noah-glassford/GameHardwareBitdisk/Final Project/FinishedControllerPhotos/4.jpg

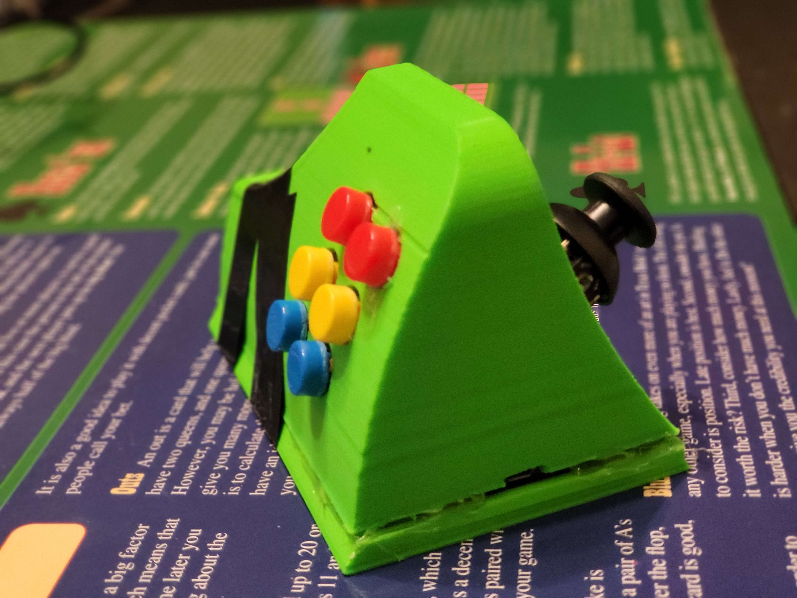
Final Project/FinishedControllerPhotos/4.jpg
