noah-glassford/GameHardwareBitdisk/Final Project/FinishedControllerPhotos/2.jpg

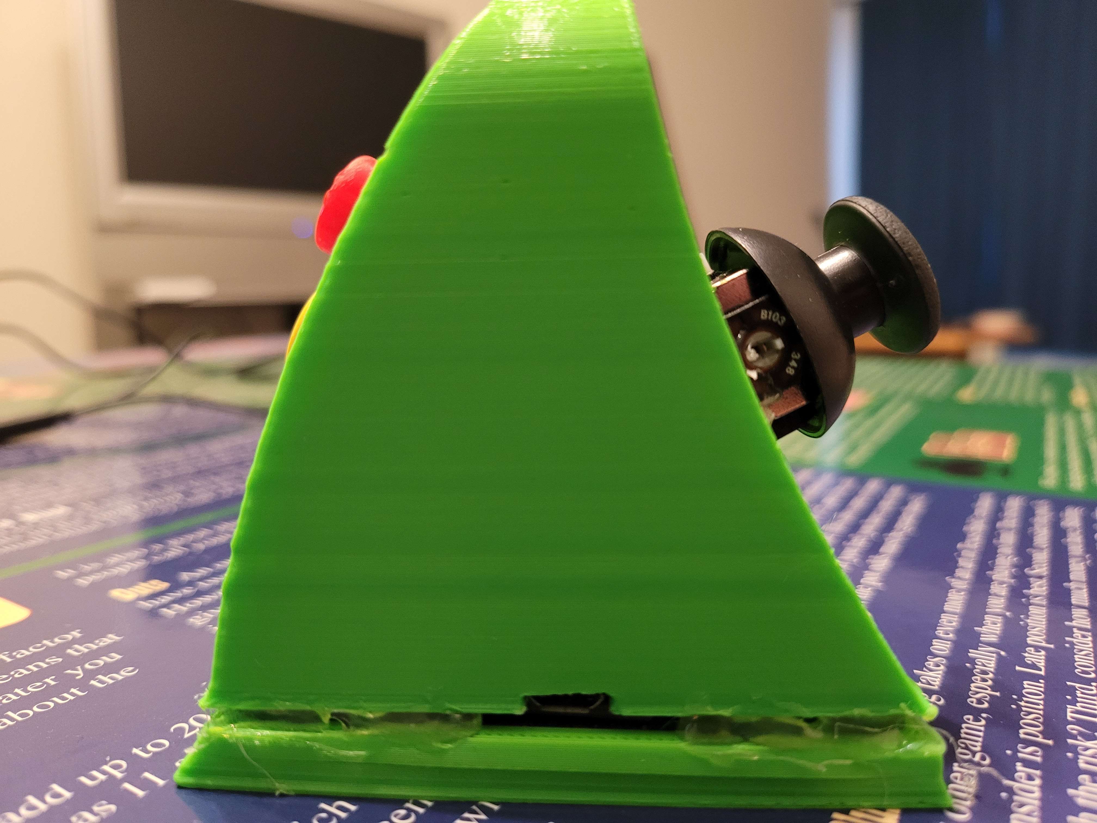
Final Project/FinishedControllerPhotos/2.jpg
