noah-glassford/GameHardwareBitdisk/Final Project/FinishedControllerPhotos/1.jpg

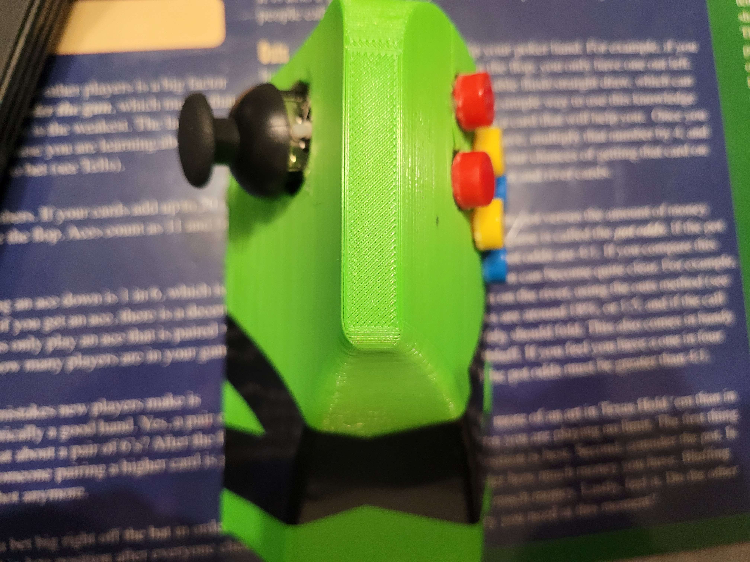
Final Project/FinishedControllerPhotos/1.jpg
