noah-glassford/GameHardwareBitdisk/Final Project/FinishedControllerPhotos/3.jpg

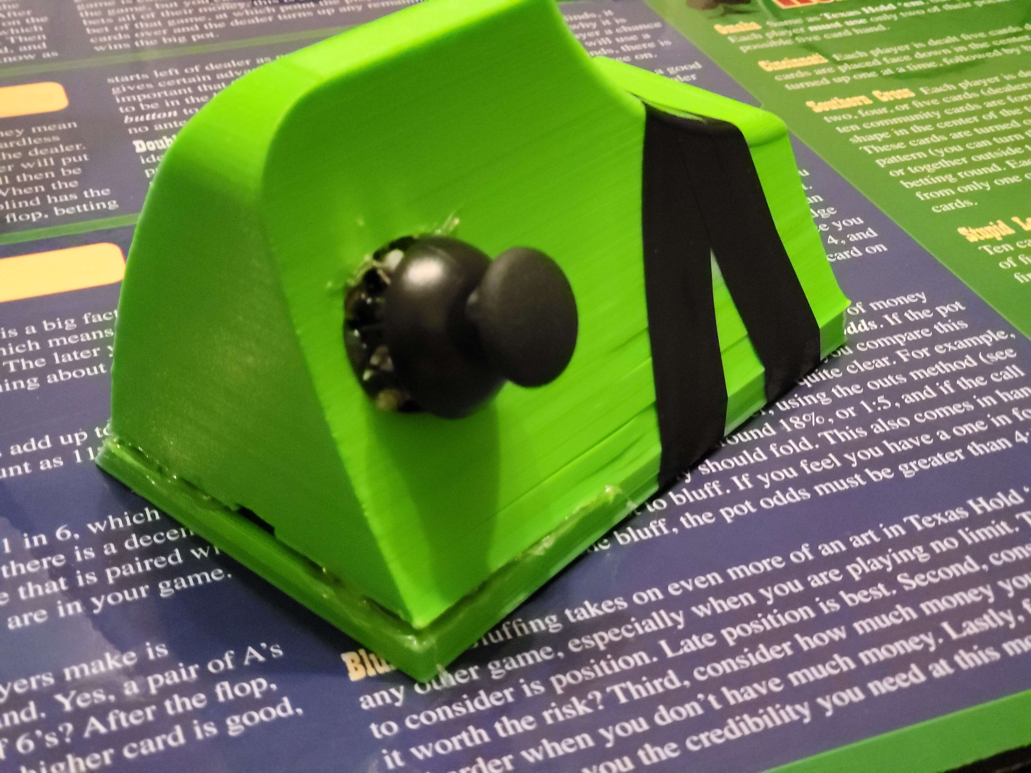
Final Project/FinishedControllerPhotos/3.jpg
