noah-glassford/GameHardwareBitdisk/Final Project/Technical Drawings/TinkercadCircuitDiagram.png

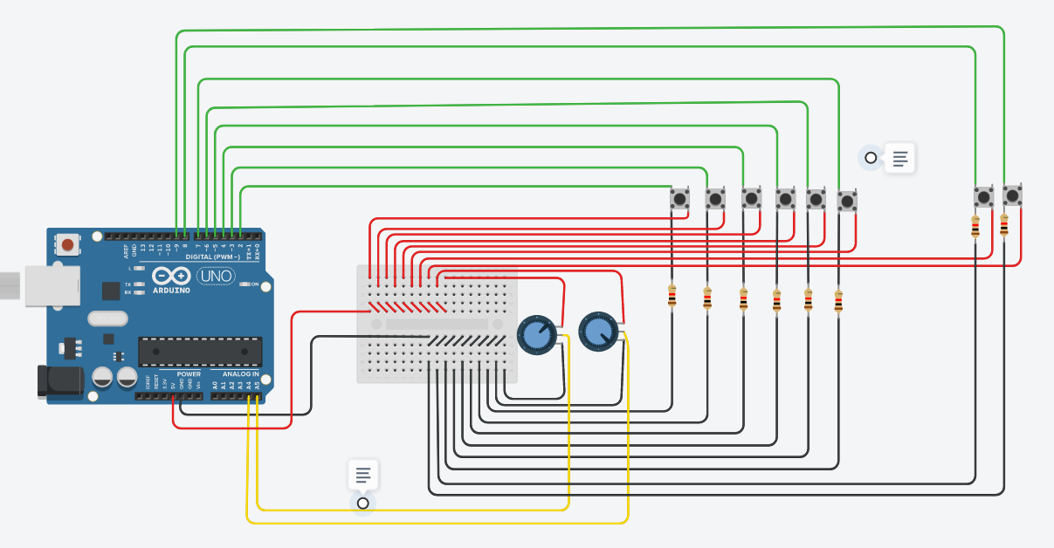
Final Project/Technical Drawings/TinkercadCircuitDiagram.png
