noah-glassford/GameHardwareBitdisk/(list of files, cad)

Other CAD files:
One-Hand-Fightstick-Iti-1.f3d
