noah-glassford/GameHardwareBitdisk/Final Project/Project Timeline/Design Process Flowchart.pdf

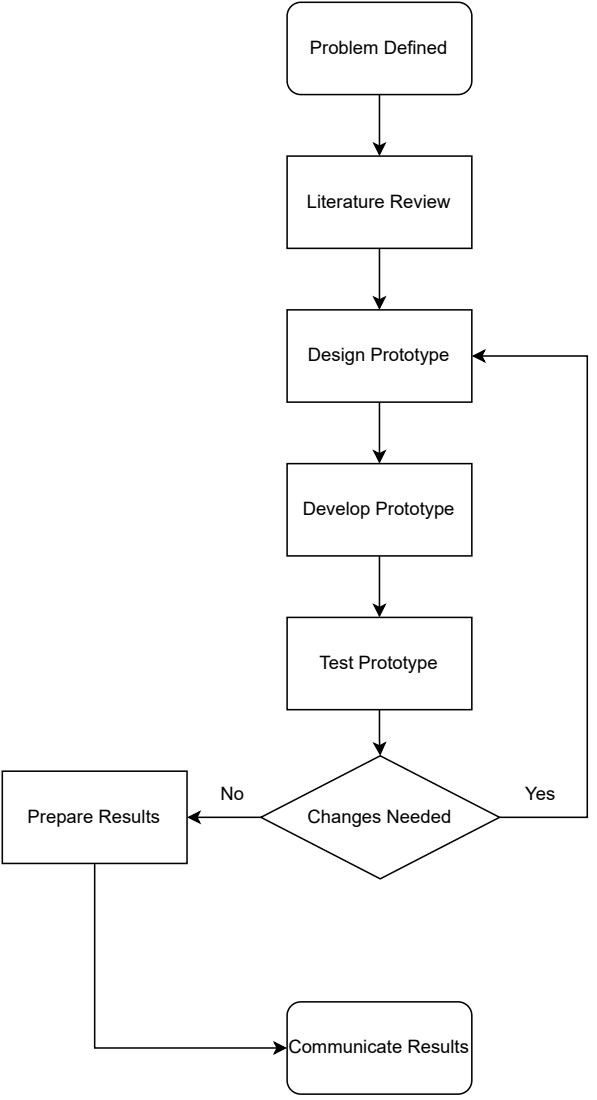
[picture p10: page 1]
Problem Defined; Literature Review; Design Prototype; Develop Prototype; Test Prototype; Changes Needed; Yes; Prepare Results; Communicate Results
