noah-glassford/GameHardwareBitdisk/Final Project/Technical Drawings/One-Handed Fightstick Exploded View Techincal Drawing.pdf

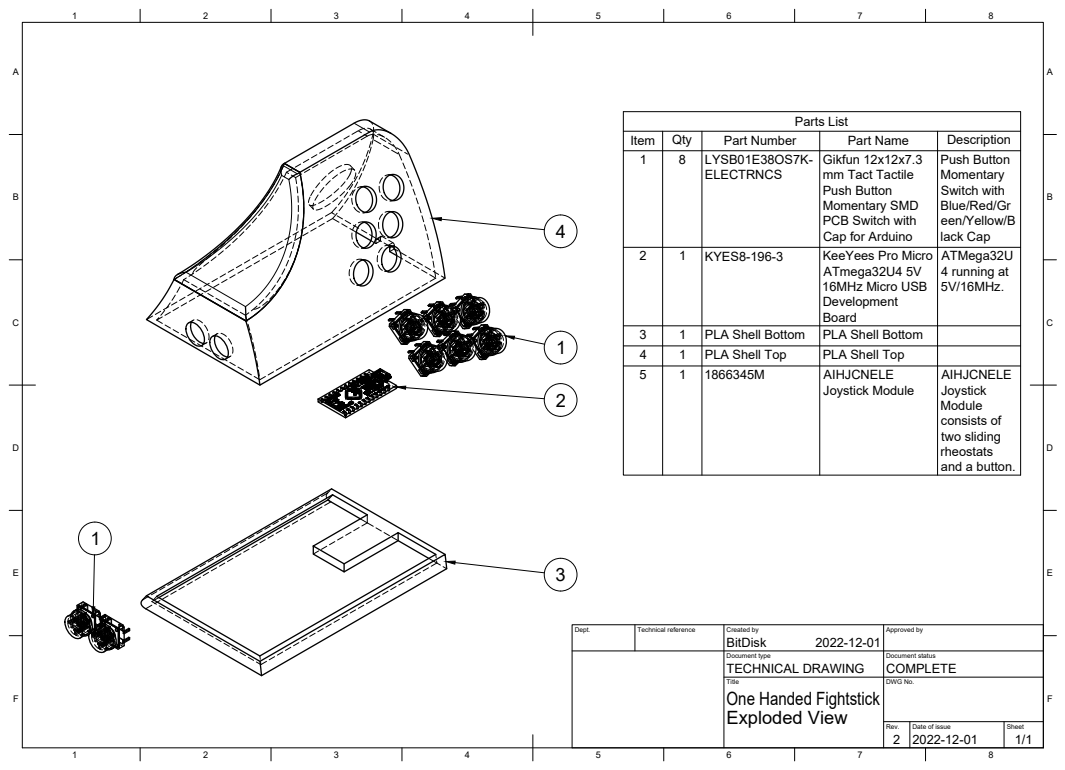
[picture p11: page 1]
8 BCDEF; ABCDEF; Dept.; Technical reference; Created by; Approved by; Document type; Document status; Title; DWG No.; Rev.; Date of issue; Sheet 2 2022-12-01; TECHNICAL DRAWING; COMPLETE; Parts List; Item; Qty; Part Number; Part Name; Description 1; LYSB01E38OS7K-; lack Cap 2; KYES8-196-3; KeeYees Pro Micro; ATmega32U4 5V 16MHz Micro USB; 4 running at; 5V/16MHz. 3; PLA Shell Bottom; PLA Shell Bottom 4; PLA Shell Top; PLA Shell Top 5; AIHJCNELE; Joystick Module; consists of two sliding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

Gikfun 12x12x7.3
mm Tact Tactile
Push Button
Momentary SMD
PCB Switch with
Cap for Arduino

Momentary
Switch with
Blue/Red/Gr
een/Yellow/B

One Handed Fightstick
Exploded View
