noah-glassford/GameHardwareBitdisk/Final Project/Technical Drawings/CircuitDiagram.pdf

A

1 | 2 | 3 | 4 | 5 | 6

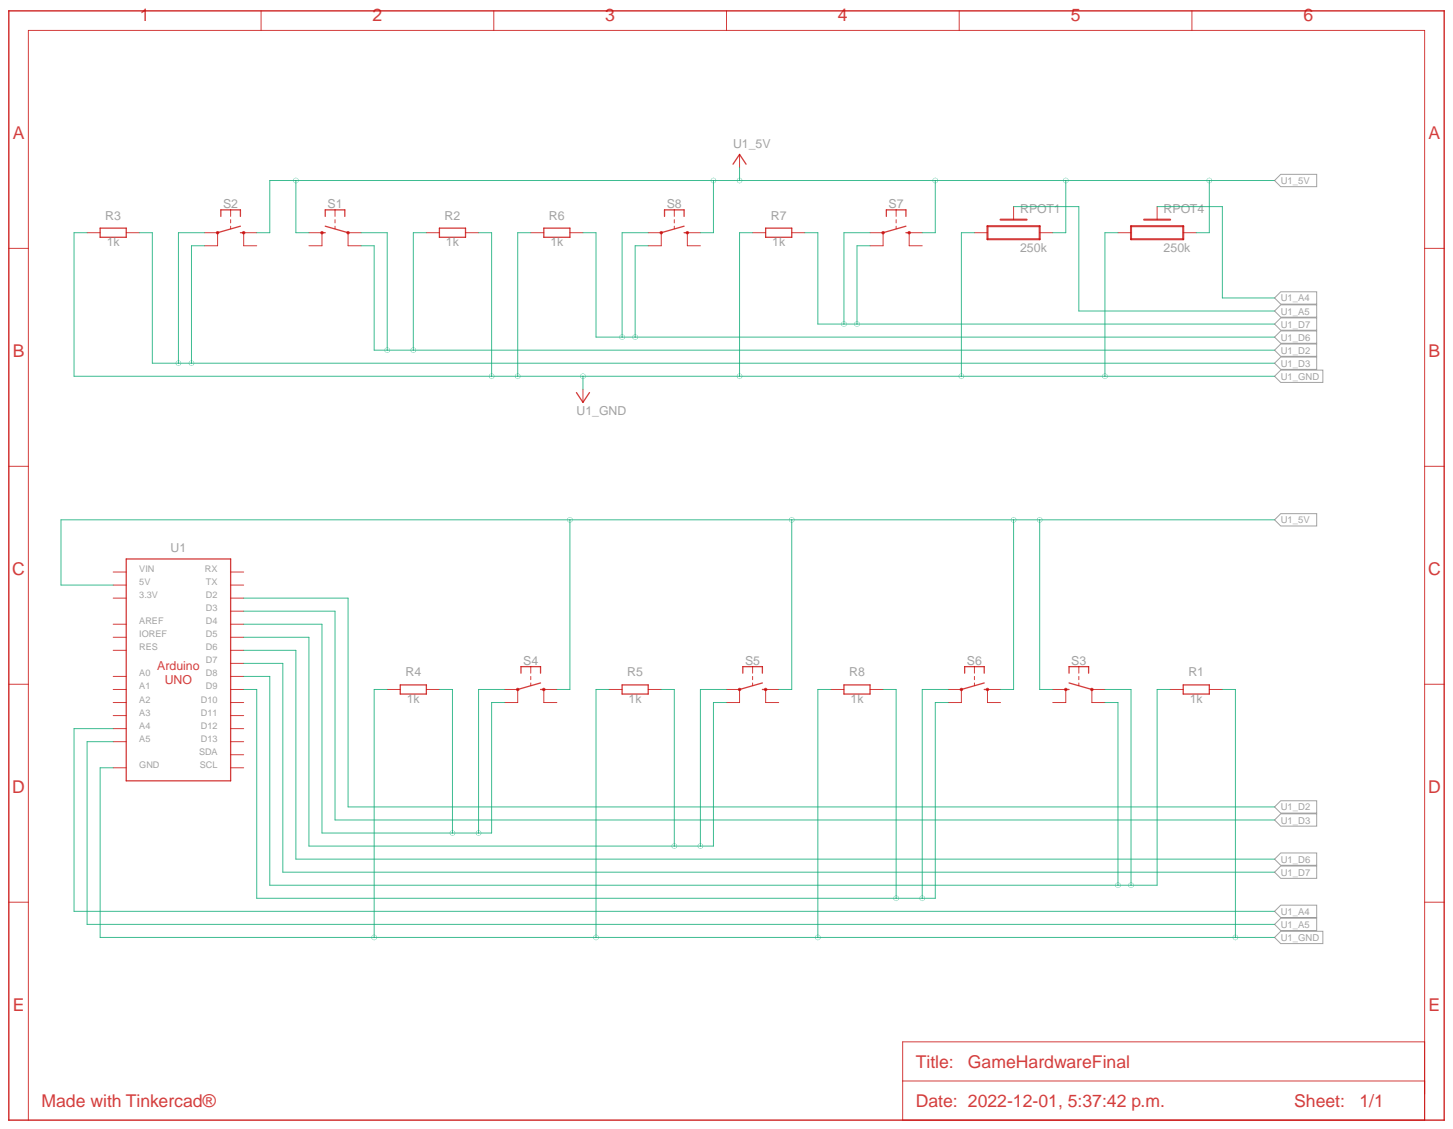
[picture p12: page 1]
