noah-glassford/GameHardwareBitdisk/Final Project/SUS and QFD/QFD House of Quality.pdf

## QFD: House of Quality

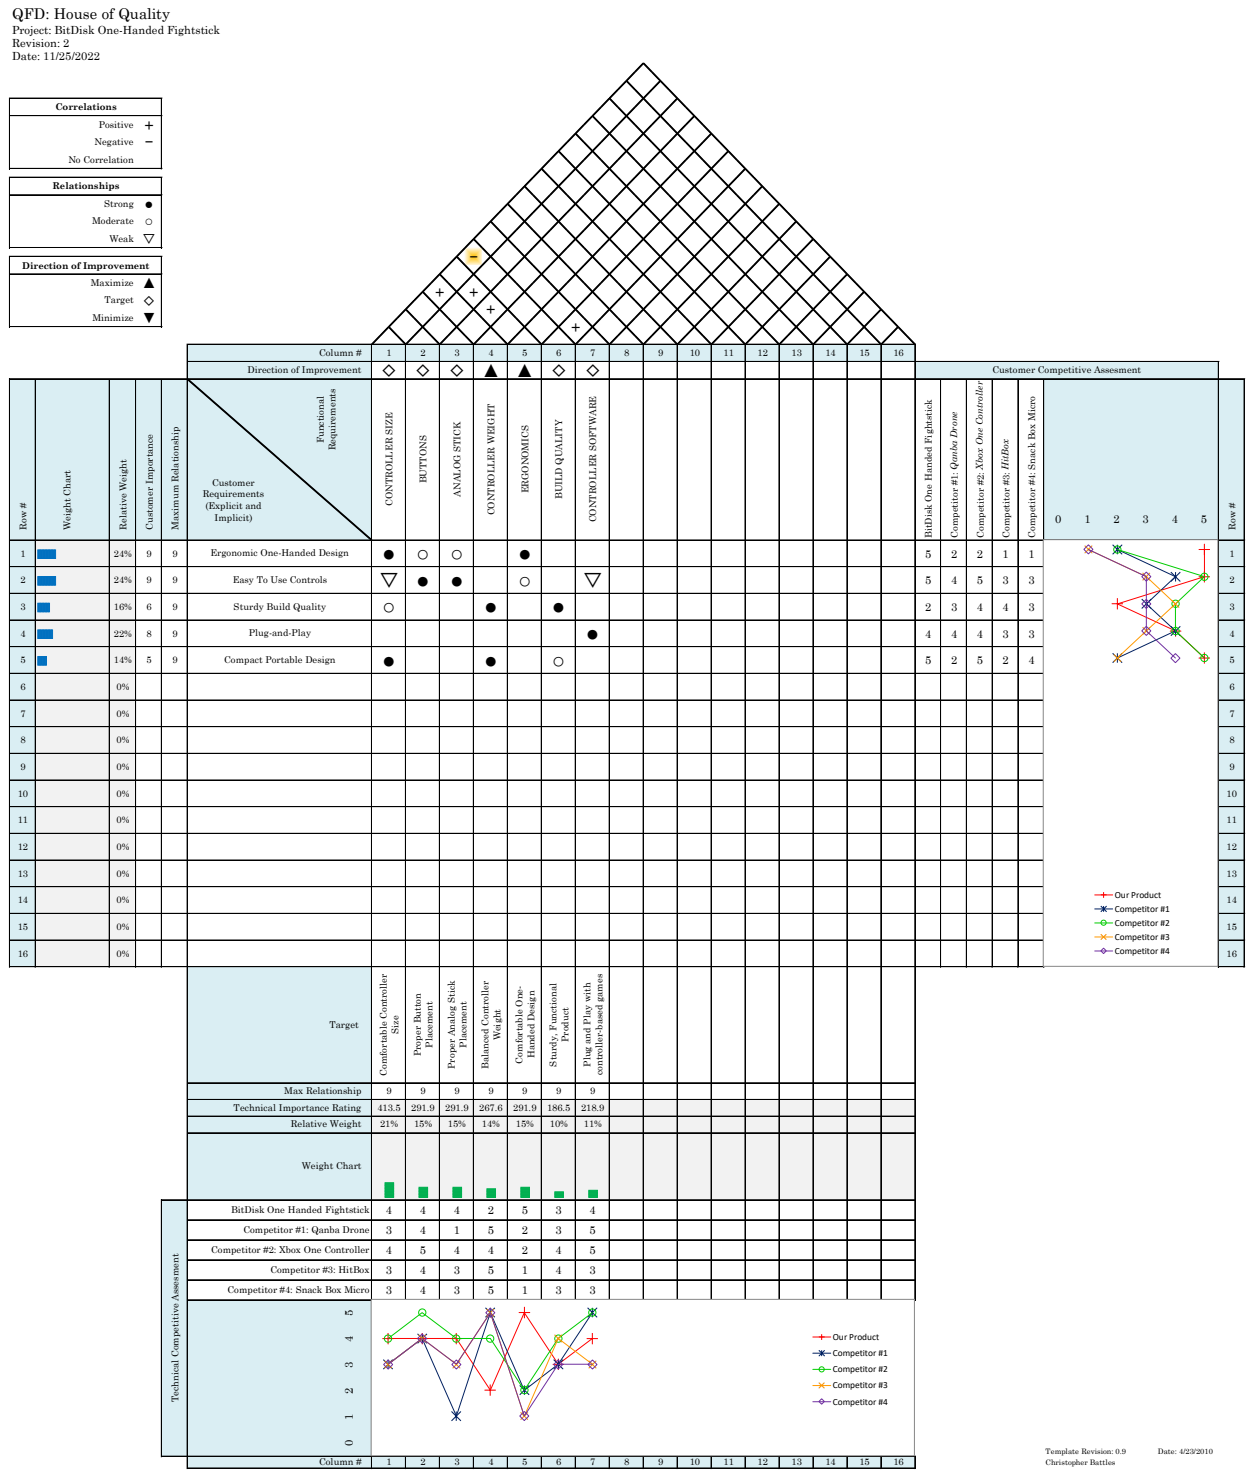
[picture p13: page 1]
Functional; Requirements; Template Revision: 0.9; Date: 4/23/2010; Christopher Battles; Maximum Relationship; Row #; Competitor #3: HitBox; Correlations; Positive; Negative; No Correlation; Relationships; Strong; Moderate; Weak ▽; Maximize; Target; Minimize; Column #; Comfortable Controller; Size; Proper Button; Placement; Balanced Controller; Weight; Comfortable One-; Handed Design; Sturdy, Functional; Product; Weight Chart; Relative Weight; Customer Importance; CONTROLLER SIZE; BUTTONS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

Project: BitDisk One-Handed Fightstick
Revision: 2
Date: 11/25/2022

Direction of Improvement

Column # | 1 | 2 | 3 | 4 | 5 | 6 | 7 | 8 | 9 | 10 | 11 | 12 | 13 | 14 | 15 | 16

Direction of Improvement | ◇ | ◇ | ◇ | ▲ | ▲ | ◇ | ◇ | | | | | | | | | | Customer Competitive Assesment

Competitor #2: Xbox One Controller

Competitor #4: Snack Box Micro

BitDisk One Handed Fightstick

Competitor #1: Qanba Drone

Customer Requirements (Explicit and Implicit) | | | | | | | | | | | | | | | | | | 0 1 2 3 4 5

1 | |||||||||||| | 24% | 9 | 9 | Ergonomic One-Handed Design | ● | ○ ○ | | | ● | | | | | | | | 5 | 2 | 2 | 1 | 1 | | 1

2 | |||||||||||| | 24% | 9 | 9 | Easy To Use Controls | ▽ | ● | ● | | ○ | | ▽ | | | | | | 5 | 4 | 5 | 3 | 3 | | 2

3 | |||||||| | 16% | 6 | 9 | Sturdy Build Quality | ○ | | | ● ● | | | | | | | | | 2 | 3 | 4 | 4 | 3 | | 3

4 | |||||||||| | 22% | 8 | 9 | Plug-and-Play | | | | | | | ● | | | | | | 4 | 4 | 4 | 3 | 3 | | 4

5 | |||||| | 14% | 5 | 9 | Compact Portable Design | ● | | | ● | | ○ | | | | | | | 5 | 2 | 5 | 2 | 4 | | 5

controller-based games

Proper Analog Stick

Plug and Play with

Target

Max Relationship | 9 | 9 | 9 | 9 | 9 | 9 | 9

Technical Importance Rating | 413.5 | 291.9 | 291.9 | 267.6 | 291.9 | 186.5 | 218.9

Relative Weight | 21% | 15% | 15% | 14% | 15% | 10% | 11%

Weight Chart

BitDisk One Handed Fightstick | 4 | 4 | 4 | 2 | 5 | 3 | 4

Competitor #1: Qanba Drone | 3 | 4 | 1 | 5 | 2 | 3 | 5

Competitor #2: Xbox One Controller | 4 | 5 | 4 | 4 | 2 | 4 | 5

Technical Competitive Assesment

Competitor #3: HitBox | 3 | 4 | 3 | 5 | 1 | 4 | 3

Competitor #4: Snack Box Micro | 3 | 4 | 3 | 5 | 1 | 3 | 3
