noah-glassford/GameHardwareBitdisk/Final Project/Technical Drawings/One-Handed Fightstick Bottom Shell Techincal Drawing.pdf

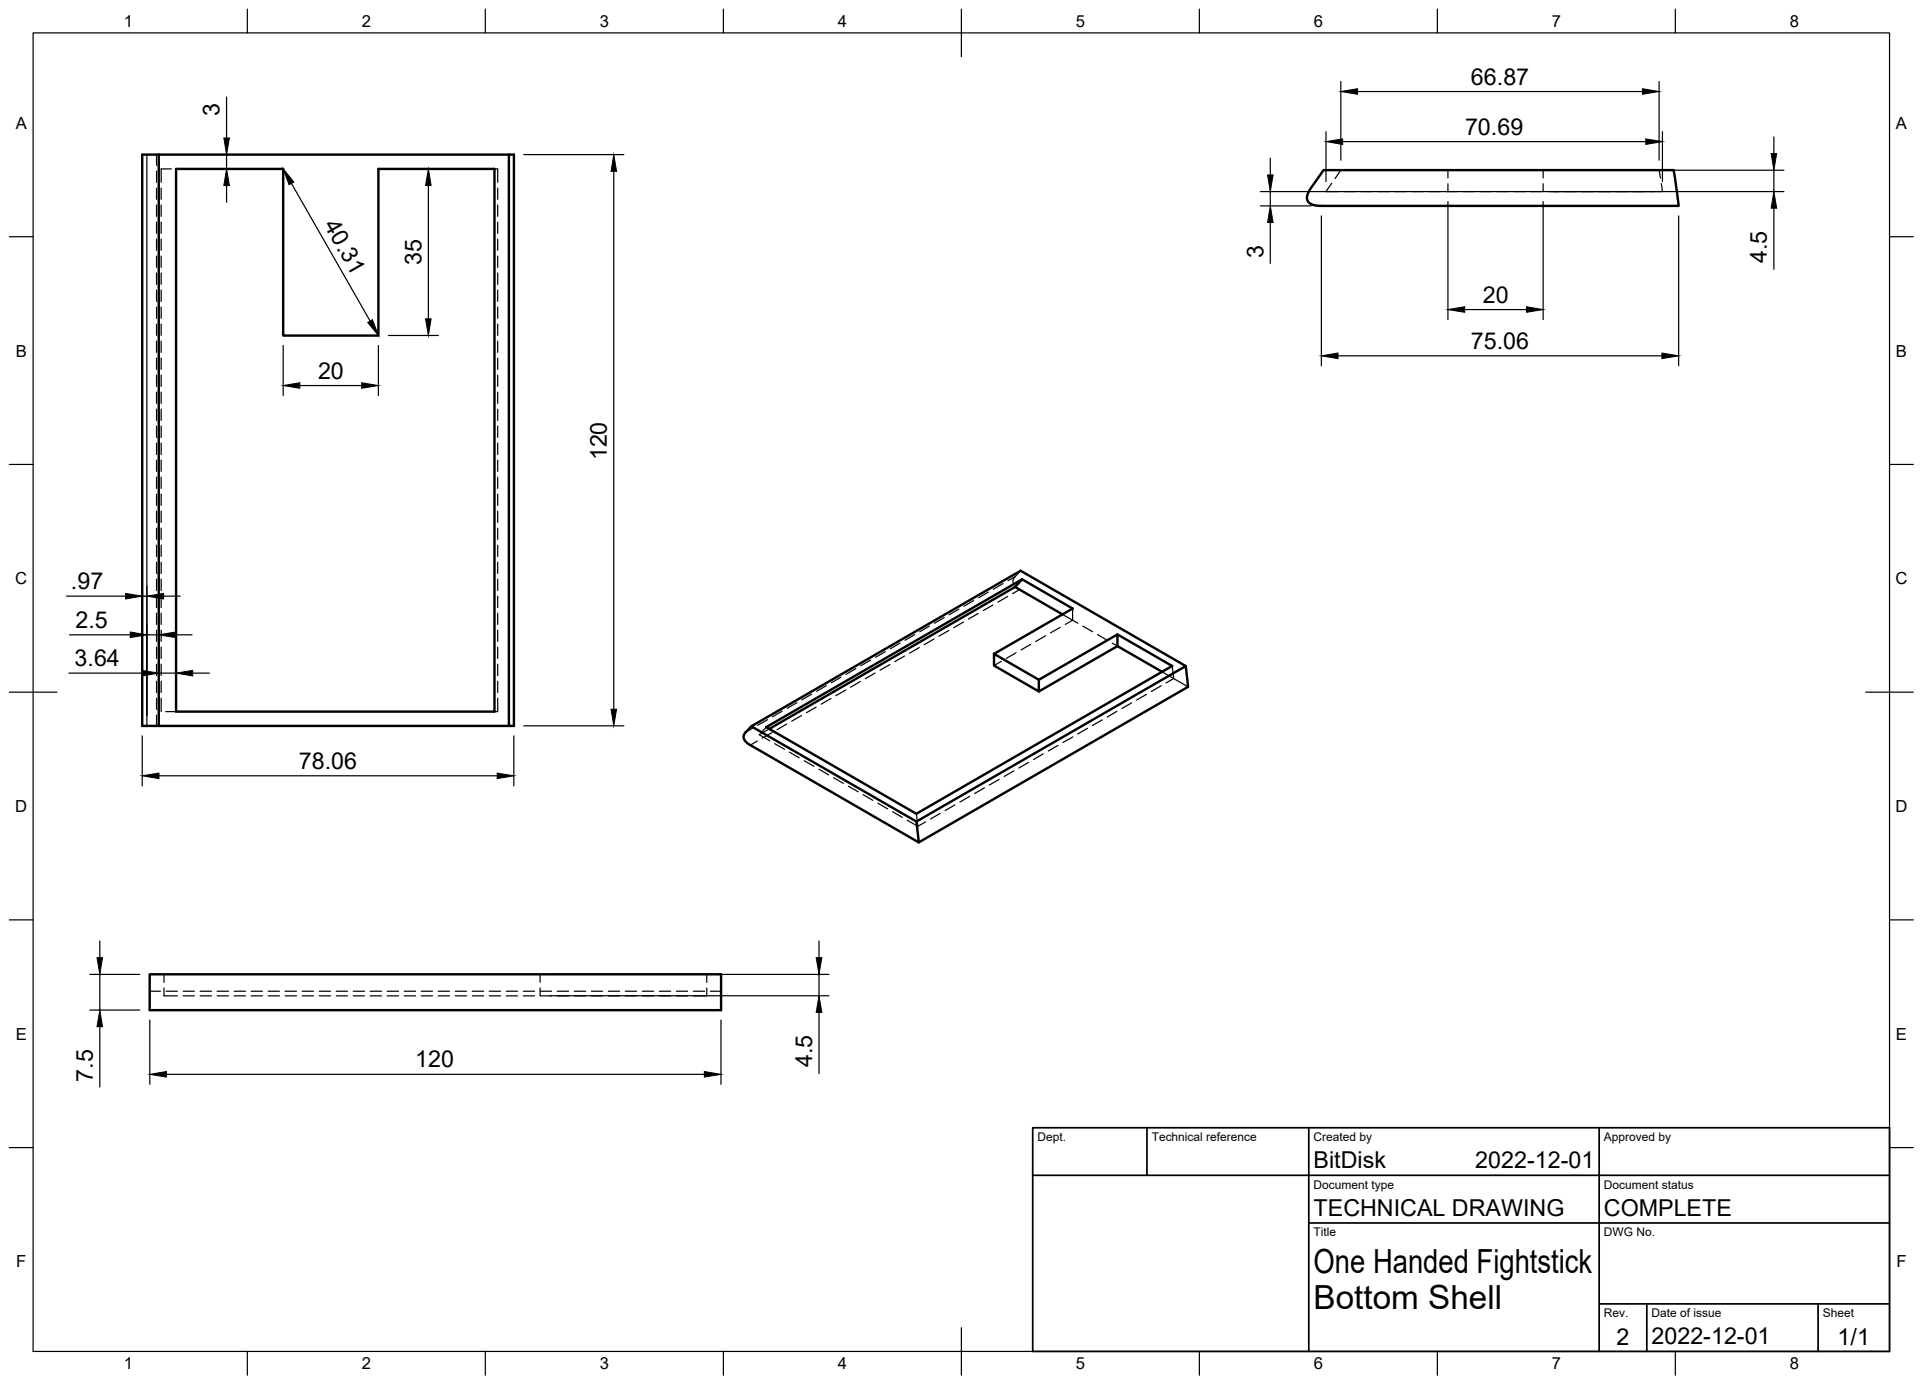
[picture p14: page 1]
Title; DWG No.; Rev.; Date of issue; Sheet

Dept. | Technical reference | Created by BitDisk 2022-12-01 | Approved by

Document type TECHNICAL DRAWING | Document status COMPLETE

One Handed Fightstick
Bottom Shell
