noah-glassford/GameHardwareBitdisk/Final Project/Technical Drawings/One-Handed Fightstick Top Shell Techincal Drawing.pdf

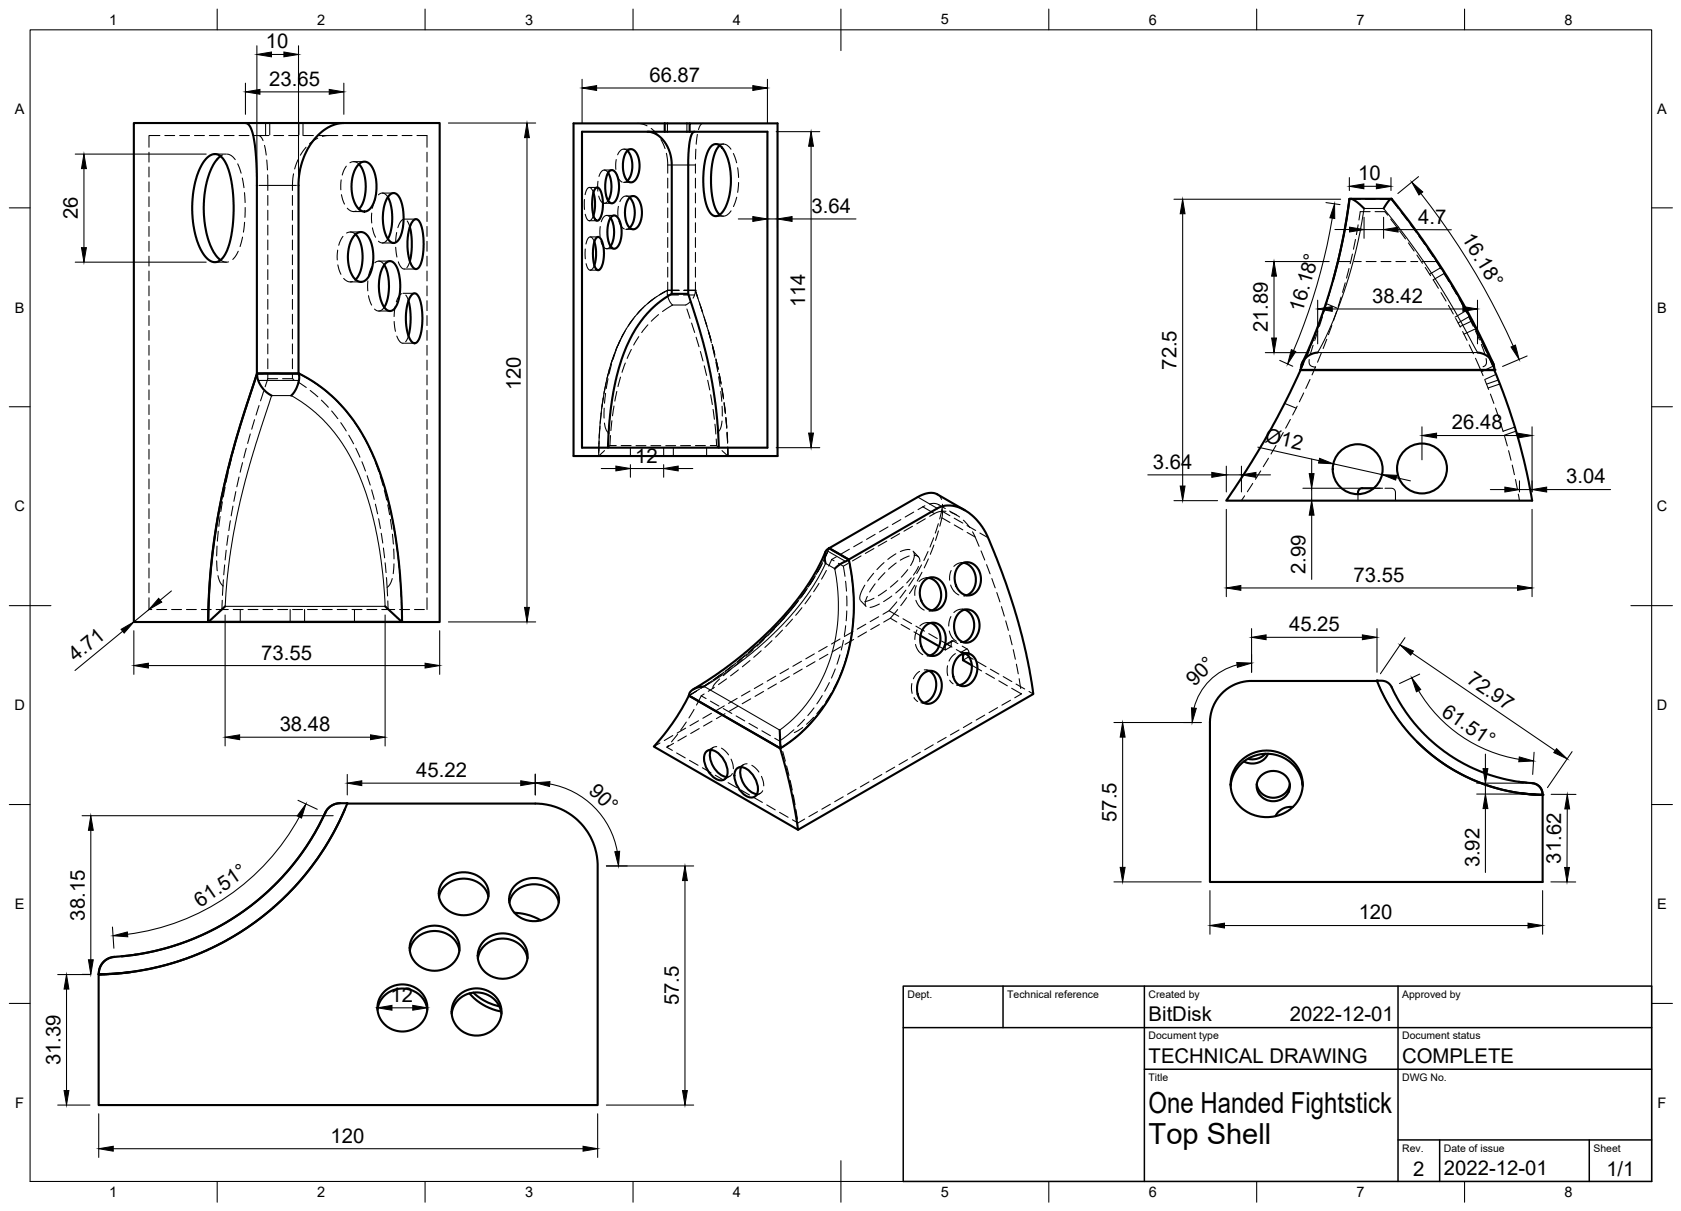
[picture p15: page 1]
8 BCDEF; ABCDEF; Title; DWG No.; Rev.; Date of issue; Sheet 2

Dept. | Technical reference | Created by 2022-12-01 | Approved by

Document type TECHNICAL DRAWING | Document status COMPLETE

One Handed Fightstick
Top Shell
