noah-glassford/GameHardwareBitdisk/(commit log)

2022-10-26 Added Fusion 360 file
    [One-Hand-Fightstick-Iti-1.f3d]
2022-11-11 A3 Files
    [One-Hand-Fightstick-Iti-1.f3d]
2022-11-11 Switching out video file for A3
2022-11-11 Added arduino code and unity project
2022-11-12 added revised controller top web print video
2022-12-01 Removed A3 files, added circuit diagrams and videos
